BBaughman7/RotorTemperatureProject/FinalDesign/ElectricalDesign/Schematic PDFs/senior_prj_board_layout.pdf

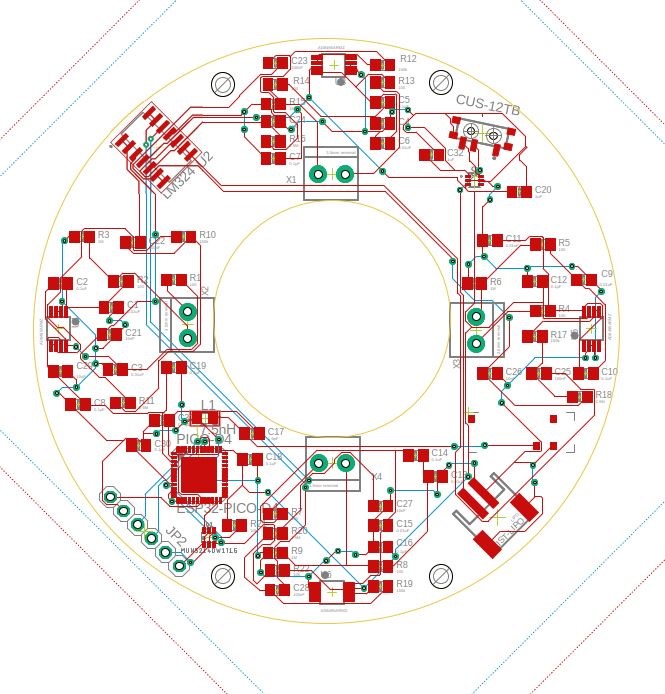
[picture p1: figure]
