BBaughman7/RotorTemperatureProject/Proof of Concept/Proof_of_Concept_BOM.xlsx

# | Description | Manufacturer/Seller | Quanity | Link | Price
1 | Breadboard | REXQualis | 1 | Link (https://www.amazon.com/Breadboards-Solderless-Breadboard-Distribution-Connecting/dp/B07DL13RZH) | $8.99
2 | TinyPico Development Board | Adafruit Industries LLC | 1 | Link (https://www.adafruit.com/product/5028) | $21.95
3 | LiPo Battery Charger | Adafruit Industries LLC | 1 | Link (https://www.adafruit.com/product/1904) | $6.95
4 | ESP-WROOM-32 Development Board | HiLetgo | 1 | Link (https://www.digipart.com/part/ESP32-WROOM-32D?msclkid=14f2ea9f09a613ca92648cae10fc4b53) | $4.10
5 | 1200 mAh LiPo Battery | Adafruit Industries LLC | 1 | Link (https://www.adafruit.com/product/258) | $9.95
6 | AD8495 Breakout Board | Adafruit Industries LLC | 1 | Link (https://www.adafruit.com/product/1778) | $11.95
7 | K-Type Thermocouple | Adafruit Industries LLC | 1 | Link (https://www.adafruit.com/product/270) | $9.95
8 | Ceramic Chip Capacitors | Kemet | 1 | Link (https://www.digikey.com/en/products/detail/kemet/CER-ENG-KIT-29/5039067) | $48.74
9 | 1/4W Axial Resistor Kit | Yageo | 1 | Link (https://www.digikey.com/en/products/detail/yageo/RS150/7109) | $41.79
10 | LM324 | TI | 1 | Link (https://www.digikey.com/en/products/detail/texas-instruments/LM324N-NOPB/4733936) | $1.17
 |  |  |  | Total | $165.54
