BBaughman7/RotorTemperatureProject/FinalDesign/Hardware/Final_Design_BOM.xlsx

Comment | Designator | Footprint | JLCPCB Part #（optional） | MFR Part# | Link to Part
0.01uF | C1,C3,C4,C6,C9,C11,C13,C15,C21,C24,C26,C27 | 0805 | C2971995 | 0805CG103J500NT | Link (https://jlcpcb.com/partdetail/3365237-0805CG103J500NT/C2971995)
0.1uF | C2,C5,C7,C8,C10,C12,C14,C16,C18,C19,C22,C23,C25,C28,C30 | 0805 | C2169476 | GCD21BR72A104KA01L | Link (https://jlcpcb.com/partdetail/2261541-GCD21BR72A104KA01L/C2169476)
0.75pF | C31 | 0805 | C519950 | CC0805CRNPO9BNR75 | Link (https://jlcpcb.com/partdetail/Yageo-CC0805CRNPO9BNR75/C519950)
1uF | C20,C32 | 0805 | C89378 | 0805F105M250NT | Link (https://jlcpcb.com/partdetail/90558-0805F105M250NT/C89378)
1.5pF | C17 | 0805 | C376869 | TCC0805COG1R5C500BT | Link (https://jlcpcb.com/partdetail/Cctc-TCC0805COG1R5C500BT/C376869)
10uF | C29 | 0805 | C17024 | CL21A106KPFNNNE | Link (https://jlcpcb.com/partdetail/17708-CL21A106KPFNNNE/C17024)
7.5nH | L1 | 0805 | C162658 | LQW2BAS7N5J00L | Link (https://jlcpcb.com/partdetail/MurataElectronics-LQW2BAS7N5J00L/C162658)
2.5M Ohm | R11,R16,R18,R20 | 0805 | C153398 | TR0805D2M5P0515 | Link (https://jlcpcb.com/partdetail/Ever_OhmsTech-TR0805D2M5P0515/C153398)
1M Ohm | R3,R6,R9,R15 | 0805 | C881016 | CR0805F1M00P05Z | Link (https://jlcpcb.com/partdetail/Ever_OhmsTech-CR0805F1M00P05Z/C881016)
150k Ohm | R10,R12,R17,R19 | 0805 | C276119 | RK73B2ATTD154J | Link (https://jlcpcb.com/partdetail/Koa_SpeerElec-RK73B2ATTD154J/C276119)
10k Ohm | R21,R22 | 0805 | C2912585 | HoAR0805-1/8W-10KR-0.1%-TCR25 | Link (https://jlcpcb.com/partdetail/C2912585)
100 Ohm | R1,R2,R4,R5,R7,R8,R13,R14 | 0805 | C346733 | RTAN0805BKE100R | Link (https://jlcpcb.com/partdetail/sei_stackpole_elec-RTAN0805BKE100R/C346733)
ESP32-PICO-D4 | PICO-D4 | QFN-48-EP(7x7) | C193707 | ESP32-PICO-D4 | Link (https://jlcpcb.com/partdetail/EspressifSystems-ESP32_PICOD4/C193707)
CUS-12TB | S | SMD | C2921739 | CUS-12TB | Link (https://jlcpcb.com/partdetail/Nidec-CUS12TB/C2921739)
LM324AMX/NOPB | U2 | SOIC-14 | C2057290 | LM324AMX/NOPB | Link (https://jlcpcb.com/partdetail/TexasInstruments-LM324AMXNOPB/C2057290)
NCP170AXV300T2G | U1 | SOT-563 | C463131 | NCP170AXV300T2G | Link (https://jlcpcb.com/partdetail/Onsemi-NCP170AXV300T2G/C463131)
PRO-OB-440 | U$35 | SMD | C5122736 | PRO-OB-440 | Link (https://jlcpcb.com/partdetail/AbraconLlc-PRO_OB440/C5122736)
MUN5214DW1T1G | Q1 | SOT-363 | C94403 | MUN5214DW1T1G | Link (https://jlcpcb.com/partdetail/Onsemi-MUN5214DW1T1G/C94403)
S2B-PH-SM4-TB(LF)(SN) | JST-LIPO | SMD,P=2mm | C295747 | S2B-PH-SM4-TB(LF)(SN) | Link (https://jlcpcb.com/partdetail/Jst-S2B_PH_SM4_TB_LF_SN/C295747)
AD8495ARMZ-R7 | U3,U4,U5,U6 | MSOP-8 | C59658 | AD8495ARMZ-R7 | Link (https://jlcpcb.com/partdetail/AnalogDevices-AD8495ARMZR7/C59658)
MF254V-11-06-1000-H70 | JP2 | Plugin,P=2.54mm | C2848407 | MF254V-11-06-1000-H70 | Link (https://jlcpcb.com/partdetail/Xfcn-MF254V_11_06_1000H70/C2848407)
DB301V-3.5-2P-GN-S | X1,X2,X3,X4 | Plugin,P=3.5mm | C695629 | DB301V-3.5-2P-GN-S | Link (https://jlcpcb.com/partdetail/Dorabo-DB301V_3_5_2P_GNS/C695629)
