BBaughman7/RotorTemperatureProject/FinalDesign/ElectricalDesign/Schematic PDFs/senior_prj_schematic.pdf

## fc = 8 Hz

U2G$1

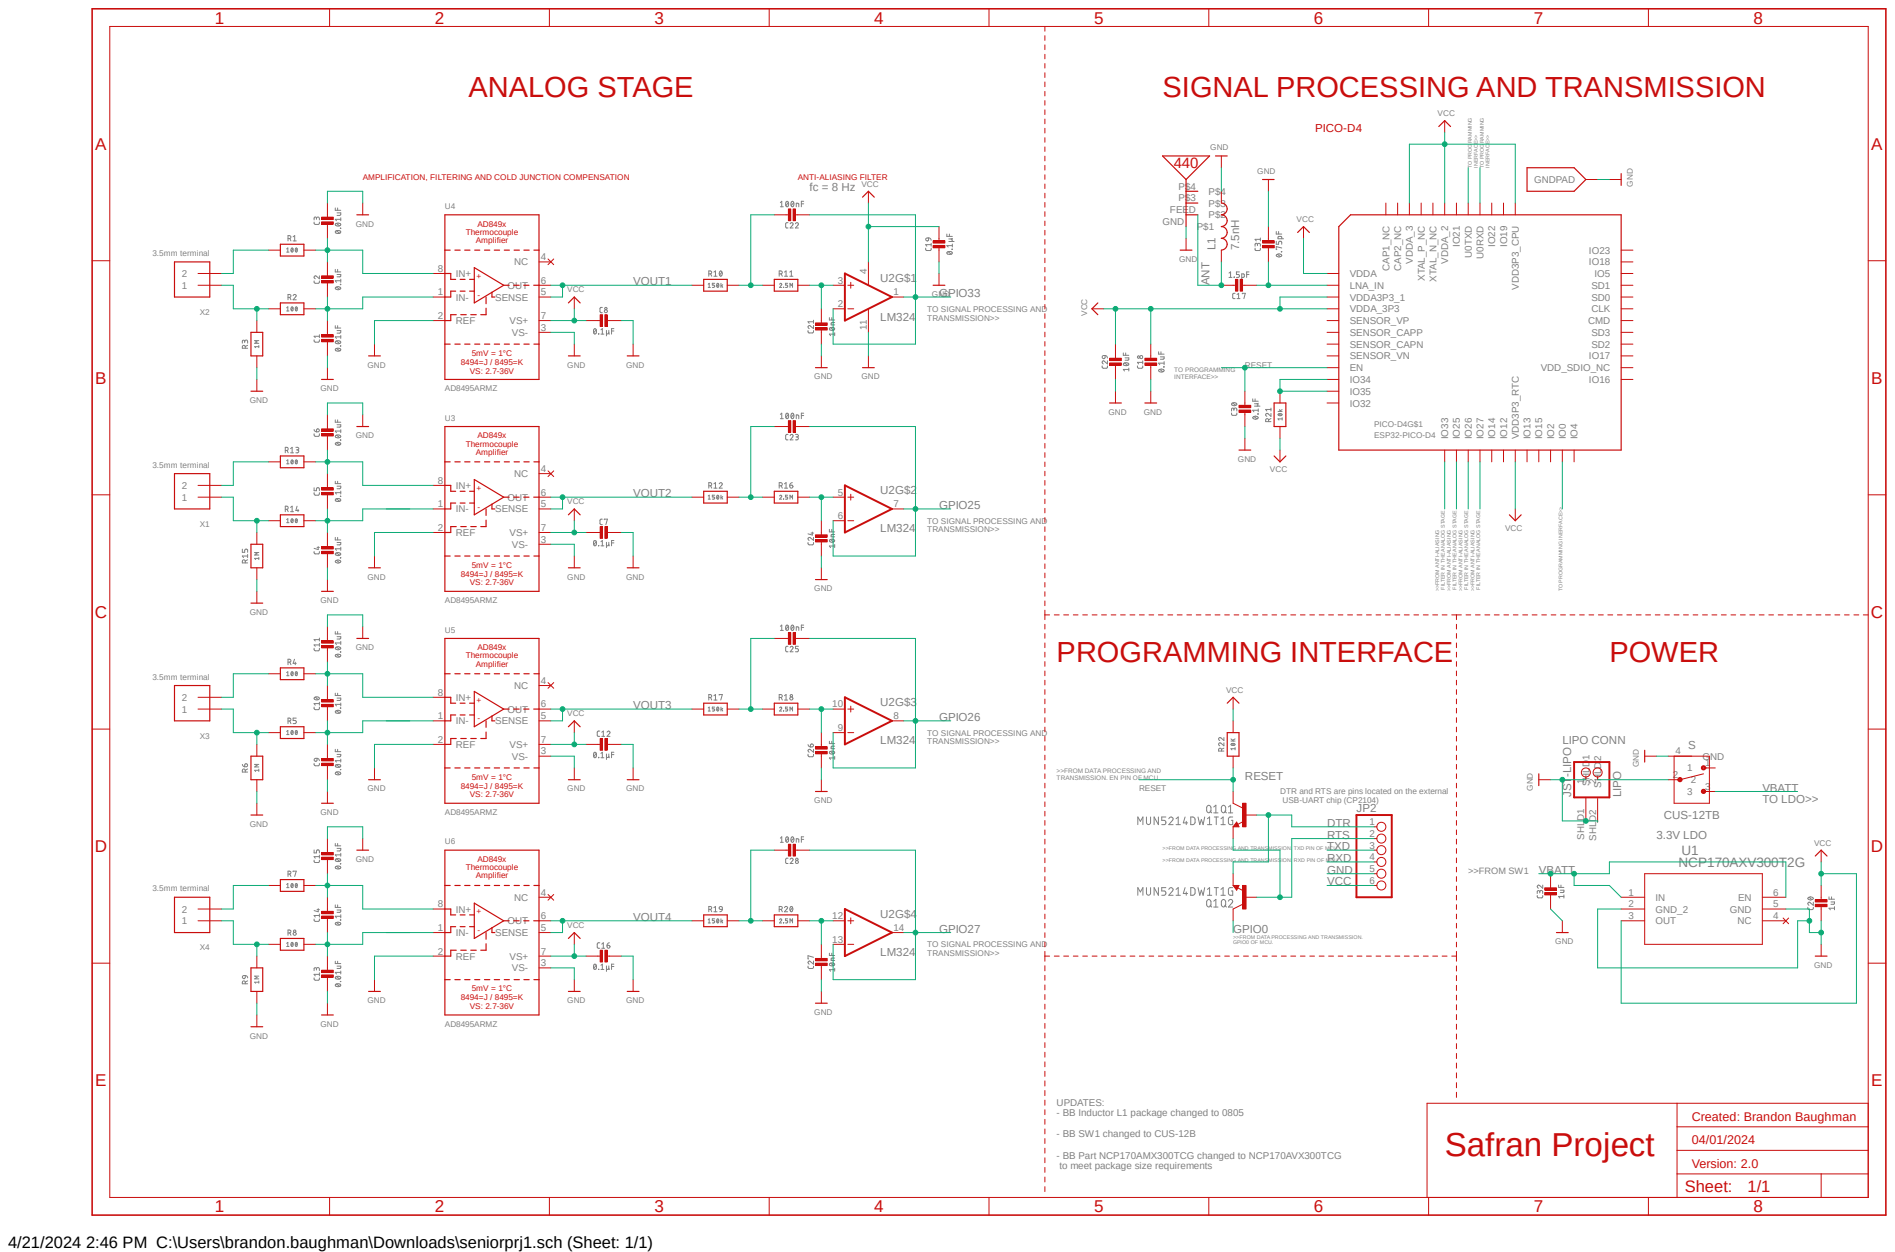
[picture p2: page 1]

SIGNAL PROCESSING AND TRANSMISSION
DTR ANT

IO23 VDD³P³_CPU IO²² IO¹⁹ U⁰TXD U⁰RXD IO²¹ VDDA_2 XTAL_P_NC XTAL_N_NC

>>FROM DATA PROCESSING AND
TRANSMISSION. EN PIN OF MCU.

DTR and RTS are pins located on the external
USB-UART chip (CP2104)

UPDATES: - BB Inductor L1 package changed to 0805

- BB SW1 changed to CUS-12B

- BB Part NCP170AMX300TCG changed to NCP170AVX300TCG
to meet package size requirements

4/21/2024 2:46 PM C:\Users\brandon.baughman\Downloads\seniorprj1.sch (Sheet: 1/1)
