BBaughman7/RotorTemperatureProject/FinalDesign/ElectricalDesign/Eagle/seniorprj1.brd

## EAGLE design FinalDesign/ElectricalDesign/Eagle/seniorprj1.brd (2024-04-30)

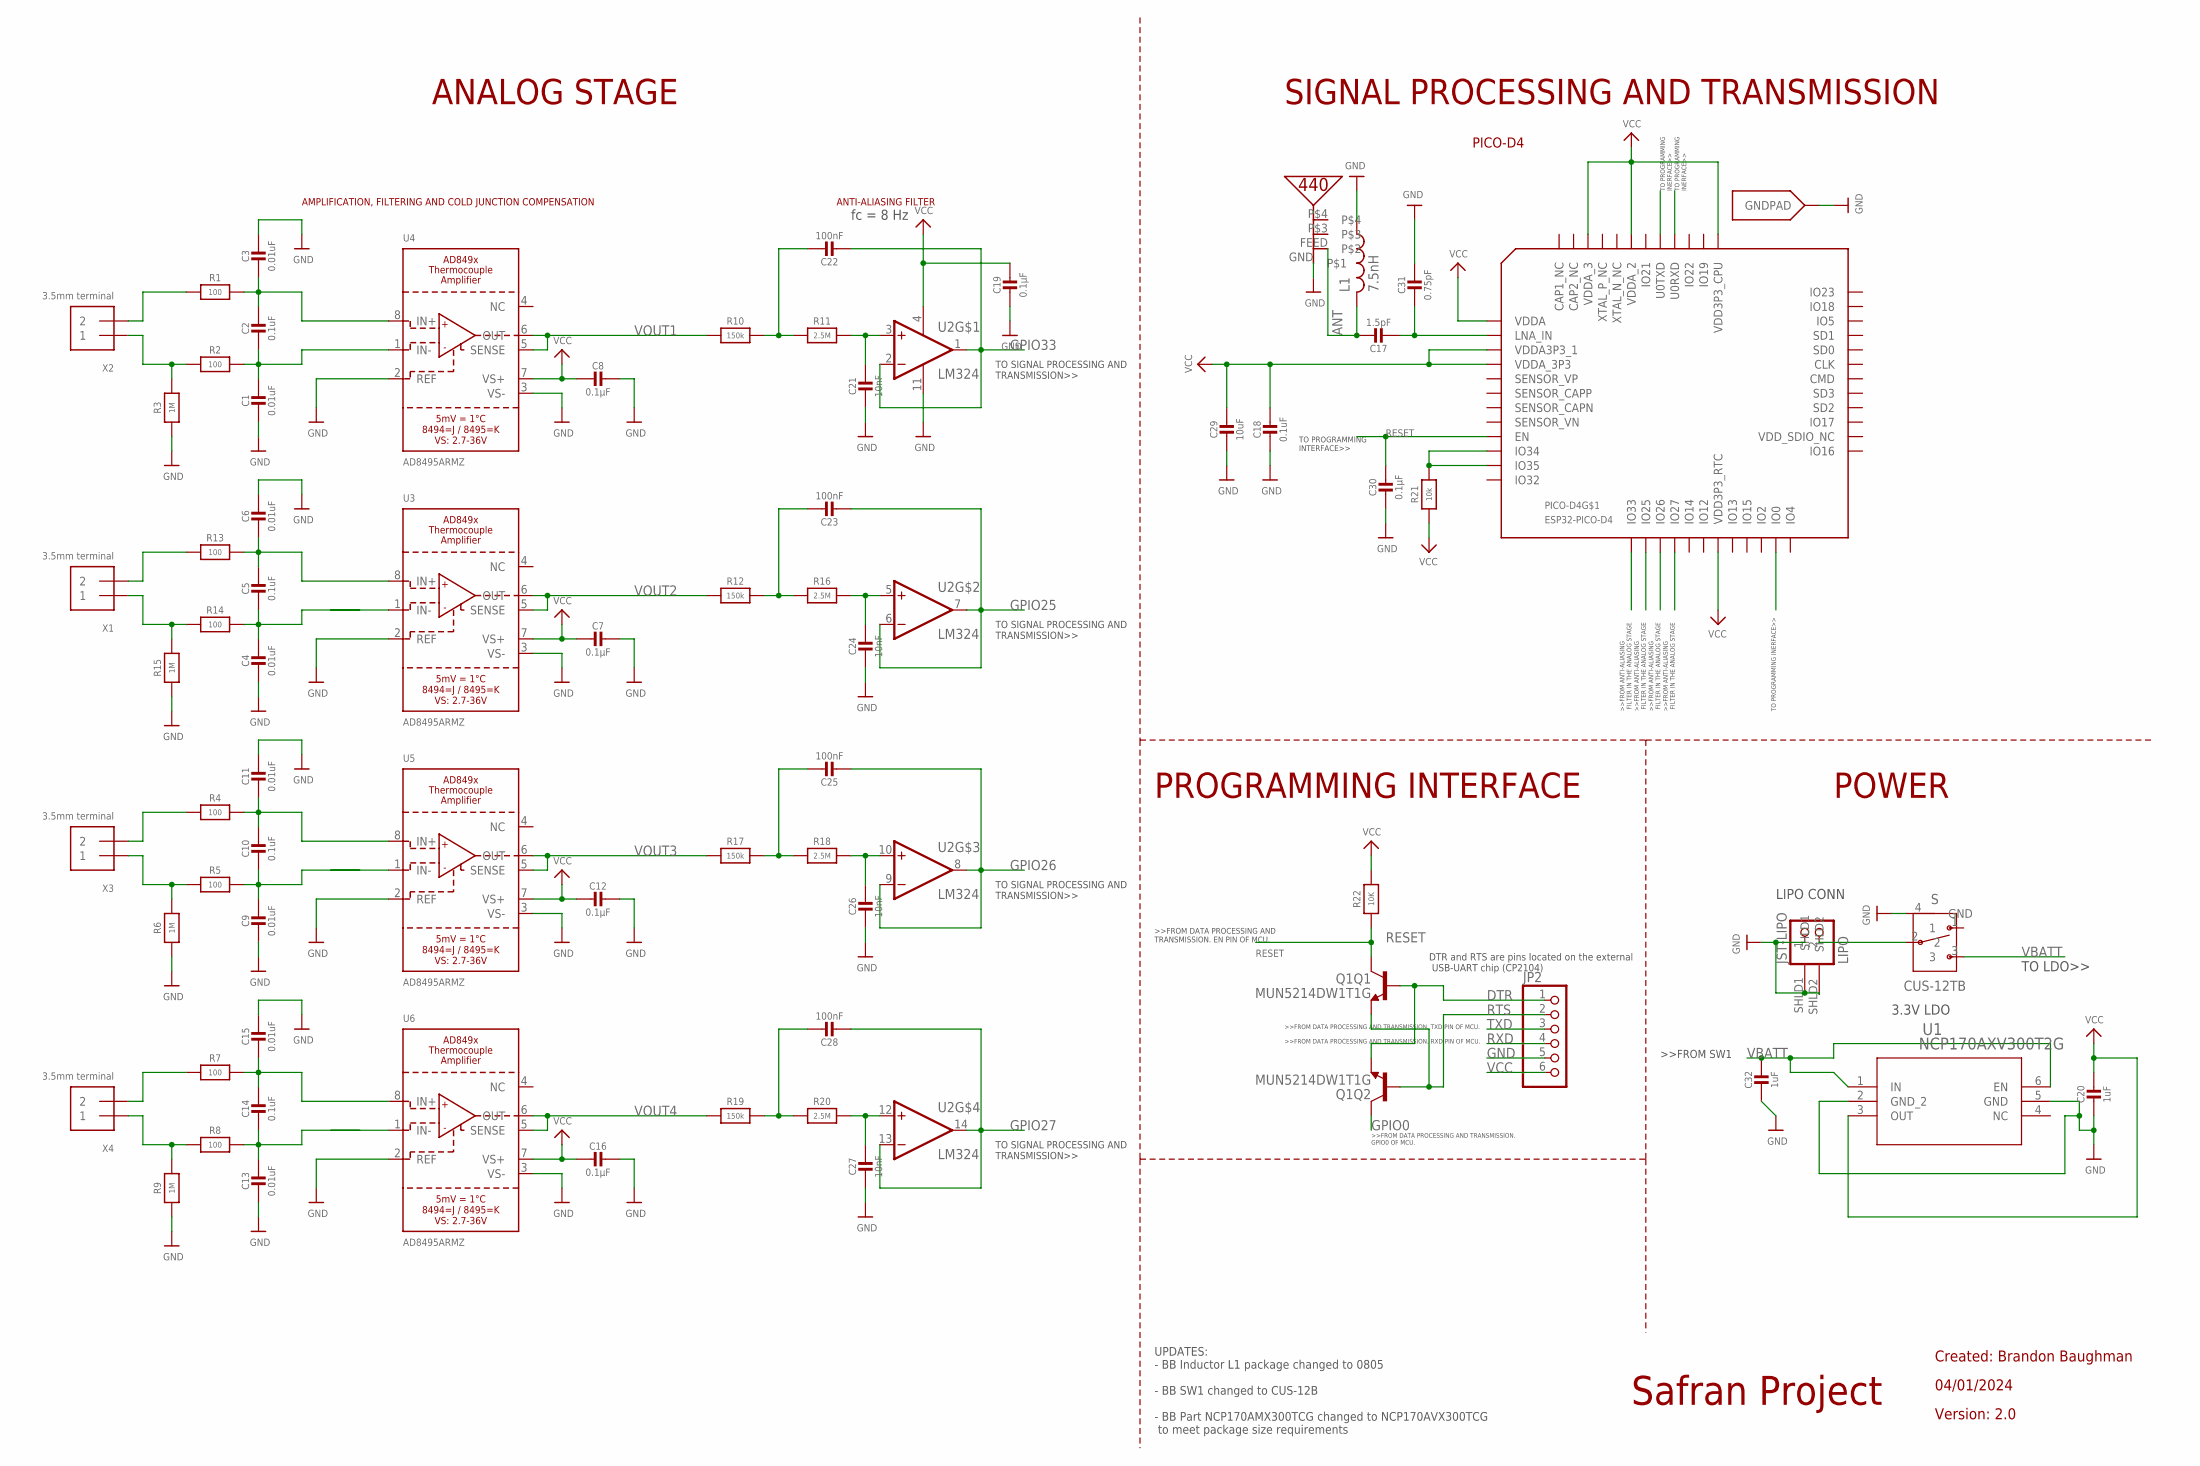
[picture p3: schematic seniorprj1.sch]

Parts:
C1, C3, C4, C6, C9, C11, C13, C15: 0.01uF; 0805-NO@1; MPN R76PD2100SE30J
C2, C5, C10, C14, C18: 0.1uF; 0805-NO@1; MPN C0805C104K1RECTU
C7, C8, C12, C16, C19, C30: 0.1µF; 0805-NO@1; MPN C0805C104K1RECTU
C17: 1.5pF; 0805-NO@1; MPN CC0805CRNPO9BN1R5
C20, C32: 1uF; 0805-NO@1; MPN 08051C105K4T2A
C21, C24, C26, C27: 10nF; 0805-NO@1; MPN C0805C103K1RECTU
C22, C23, C25, C28: 100nF; 0805-NO@1; MPN C0805C104K1RECTU
C29: 10uF; 0805-NO@1; MPN C0805C106J8RACAUTO
C31: 0.75pF; 0805-NO@1
JP2: PINHD-1X6; 1X06; MPN 826631-6
JST-LIPO: LIPO; JSTPH2
L1: 7.5nH; RESC0805_N; MPN BSPQ000603047N5H00
PICO-D4: ESP32-PICO-D4; PICO-D4-QFN48
Q1: MUN5214DW1T1G; DUAL_NPN_SC70-6; MPN MUN5214DW1T1G
R1, R2, R4, R5, R7, R8, R13, R14: 100; 0805-NO; MPN CRCW0805100RFKTA
R3, R6, R9, R15: 1M; 0805-NO; MPN ERJ-P06J105V
R10, R12, R17, R19: 150k; 0805-NO; MPN CRCW0805150KFKEA
R11, R16, R18, R20: 2.5M; 0805-NO
R21: 10k; 0805-NO; MPN RC0805FR-0710KL
R22: 10K; 0805-NO; MPN RC0805FR-0710KL
S: CUS-12TB; CUS-12B
U1: NCP170AXV300T2G; SOT-563_1P3X1P7_ONS
U2: LM324; SOIC127P600X175-14N; MPN LM324N/NOPB
U3, U4, U5, U6: AD8495ARMZ; MSOP8_0.65MM; MPN AD8495ARMZ-R7
U$35: PRO-OB-440
X1, X2, X3, X4: 3.5mm terminal; TERMBLOCK_1X2-3.5MM; MPN MA212-350M02

Connections:
ANT: C17.1, L1.2, U$35.FEED
DTR: JP2.1, Q1.1 (E), Q1.5 (B)
GND: C1.2, C3.1, C4.2, C6.1, C7.1, C8.1, C9.2, C11.1, C12.1, C13.2, C15.1, C16.1, C18.2, C19.2, C20.2, C21.2, C24.2, C26.2, C27.2, C29.2, C30.2, C31.1, C32.2, JP2.5, JST-LIPO.1, JST-LIPO.SHLD1, JST-LIPO.SHLD2, L1.1, PICO-D4.EXP (GNDPAD), R3.1, R6.1, R9.1, R15.1, S.4 (GND), U1.2 (GND_2), U1.5 (GND), U2.11 (VCC-), U3.2 (REF), U3.3 (VS-), U4.2 (REF), U4.3 (VS-), U5.2 (REF), U5.3 (VS-), U6.2 (REF), U6.3 (VS-), U$35.GND
GPIO0: PICO-D4.23 (IO0), Q1.6 (C)
GPIO25: C23.2, U2.6 (INVERTING_INPUT2), U2.7 (OUTPUT2)
GPIO26: C25.2, U2.8 (OUTPUT3), U2.9 (INVERTING_INPUT3)
GPIO27: C28.2, U2.13 (INVERTING_INPUT4), U2.14 (OUTPUT4)
GPIO33: C22.2, U2.1 (OUTPUT1), U2.2 (INVERTING_INPUT1)
IN+: R13.1, X1.2
IN+1: R1.1, X2.2
IN+2: R4.1, X3.2
IN+3: R7.1, X4.2
IN-: R14.1, R15.2, X1.1
IN-1: R2.1, R3.2, X2.1
IN-2: R5.1, R6.2, X3.1
IN-3: R8.1, R9.2, X4.1
IO12: PICO-D4.18 (IO12)
IO21: PICO-D4.42 (IO21)
LNA_IN: C17.2, C31.2, PICO-D4.2 (LNA_IN)
unnamed: C2.1, C3.2, R1.2, U4.8 (IN+)
unnamed: C5.1, C6.2, R13.2, U3.8 (IN+)
unnamed: C4.1, C5.2, R14.2
unnamed: C1.1, C2.2, R2.2, U4.1 (IN-)
unnamed: C10.1, C11.2, R4.2, U5.8 (IN+)
unnamed: C9.1, C10.2, R5.2
unnamed: C14.1, C15.2, R7.2, U6.8 (IN+)
unnamed: C13.1, C14.2, R8.2
unnamed: JST-LIPO.2, S.2
unnamed: C22.1, R10.2, R11.1
unnamed: C21.1, R11.2, U2.3 (NON-INVERTING_INPUT1)
unnamed: C24.1, R16.2, U2.5 (NON-INVERTING_INPUT2)
unnamed: C23.1, R12.2, R16.1
unnamed: C25.1, R17.2, R18.1
unnamed: C28.1, R19.2, R20.1
unnamed: C26.1, R18.2, U2.10 (NON-INVERTING_INPUT3)
unnamed: C27.1, R20.2, U2.12 (NON-INVERTING_INPUT4)
unnamed: PICO-D4.10 (IO34), PICO-D4.11 (IO35), R21.2
RESET: C30.1, PICO-D4.9 (EN), Q1.3 (C), R22.1
RTS: JP2.2, Q1.2 (B), Q1.4 (E)
RXD: JP2.4, PICO-D4.40 (U0RXD)
SENSOR_CAPN: PICO-D4.7 (SENSOR_CAPN)
TXD: JP2.3, PICO-D4.41 (U0TXD)
VBATT: C32.1, S.3, U1.1 (IN), U1.6 (EN)
VCC: C7.2, C8.2, C12.2, C16.2, C18.1, C19.1, C20.1, C29.1, JP2.6, PICO-D4.1 (VDDA), PICO-D4.3 (VDDA3P3_1), PICO-D4.4 (VDDA_3P3), PICO-D4.19 (VDD3P3_RTC), PICO-D4.37 (VDD3P3_CPU), PICO-D4.43 (VDDA_2), PICO-D4.46 (VDDA_3), R21.1, R22.2, U1.3 (OUT), U2.4 (VCC+), U3.7 (VS+), U4.7 (VS+), U5.7 (VS+), U6.7 (VS+)
VOUT1: R10.1, U4.5 (SENSE), U4.6 (OUT)
VOUT2: R12.1, U3.5 (SENSE), U3.6 (OUT)
VOUT3: R17.1, U5.5 (SENSE), U5.6 (OUT)
VOUT4: R19.1, U6.5 (SENSE), U6.6 (OUT)

Notes on the sheet:
LIPO CONN
Created: Brandon Baughman
Safran Project
04/01/2024
Version: 2.0
PICO-D4
ANALOG STAGE
PROGRAMMING INTERFACE
POWER
SIGNAL PROCESSING AND TRANSMISSION
UPDATES: - BB Inductor L1 package changed to 0805 - BB SW1 changed to CUS-12B - BB Part NCP170AMX300TCG changed to NCP170AVX300TCG to meet package size requirements
DTR and RTS are pins located on the external USB-UART chip (CP2104)
AMPLIFICATION, FILTERING AND COLD JUNCTION COMPENSATION
ANTI-ALIASING FILTER
TO SIGNAL PROCESSING AND TRANSMISSION>>
TO PROGRAMMING INERFACE>>
TO PROGRAMMING INTERFACE>>
TO PROGRAMMING INERFACE>>
TO LDO>>
3.3V LDO
fc = 8 Hz

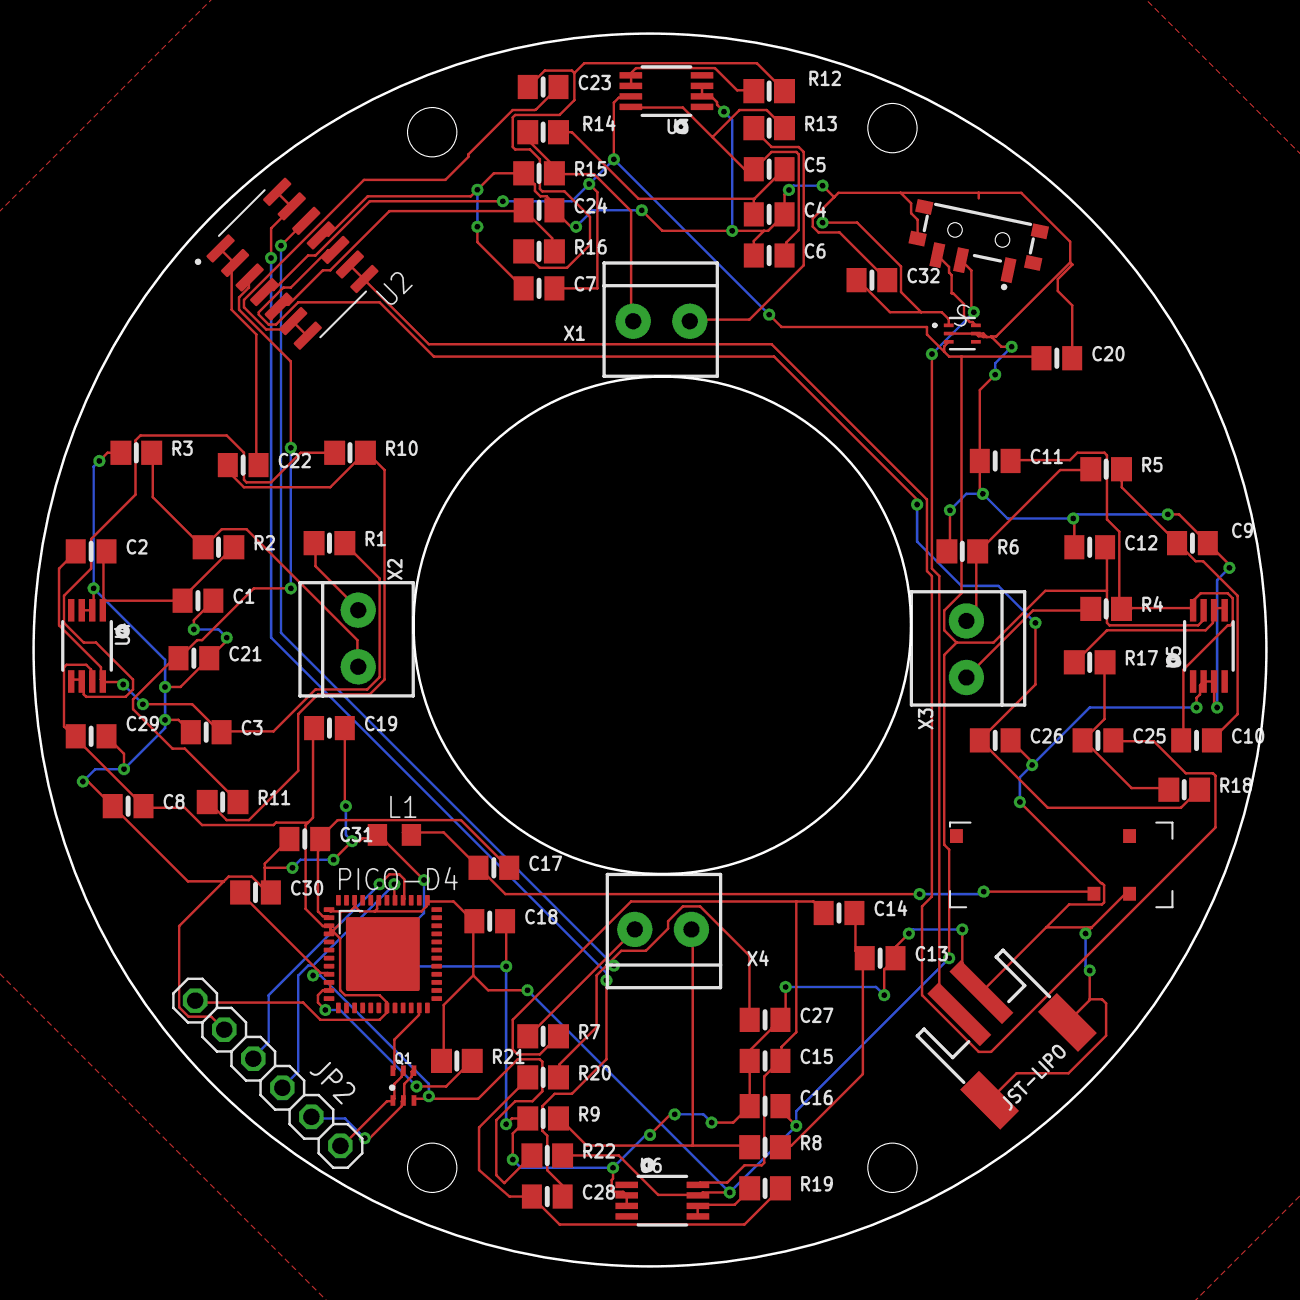
[picture p4: board seniorprj1.brd from above]

Board: 2 copper layers, 76.2 x 76.2 mm, 71 parts (0 on the bottom side), 45 nets.
