BBaughman7/RotorTemperatureProject/FinalDesign/Software/BLE_Client/ESP32_BLE_TEMP_CLIENT.ino

#include "BLEDevice.h"


static BLEUUID serviceUUID((uint16_t)0x181A);//service UUID from the server
static BLEUUID charUUID((uint16_t)0x2A6E);//characteritic UUID from server

static boolean doConnect = false;
static boolean connected = false;
static boolean doScan = false;
static BLERemoteCharacteristic* pRemoteCharacteristic;
static BLEAdvertisedDevice* myDevice;



static void notifyCallback(BLERemoteCharacteristic* pBLERemoteCharacteristic,uint8_t* pData,size_t length, bool isNotify) 
{    
    Serial.println((char*)pData);
}

class MyClientCallback : public BLEClientCallbacks 
{
  void onConnect(BLEClient* pclient) 
  {
  }

  void onDisconnect(BLEClient* pclient) 
  {
    connected = false;
    Serial.println("onDisconnect");
  }
};

bool connectToServer() 
{
    BLEClient*  pClient  = BLEDevice::createClient();
    pClient->setClientCallbacks(new MyClientCallback());

    // Connect to the BLE Server.
    pClient->connect(myDevice);  // if you pass BLEAdvertisedDevice instead of address, it will be recognized type of peer device address (public or private)

    // Obtain a reference to the service we are after in the remote BLE server.
    BLERemoteService* pRemoteService = pClient->getService(serviceUUID);
    if (pRemoteService == nullptr)
    {   
      pClient->disconnect();
      return false;
    }

    // Obtain a reference to the characteristic in the service of the remote BLE server.
    pRemoteCharacteristic = pRemoteService->getCharacteristic(charUUID);
    if (pRemoteCharacteristic == nullptr) 
    {
      pClient->disconnect();
      return false;
    }

    // Read the value of the characteristic.
    if(pRemoteCharacteristic->canRead()) 
    {
      std::string value = pRemoteCharacteristic->readValue();
    }

    if(pRemoteCharacteristic->canNotify())
      pRemoteCharacteristic->registerForNotify(notifyCallback);

    connected = true;
    return true;
}
/**
 * Scan for BLE servers and find the first one that advertises the service we are looking for.
 */
class MyAdvertisedDeviceCallbacks: public BLEAdvertisedDeviceCallbacks 
{
   // Called for each advertising BLE server.
  void onResult(BLEAdvertisedDevice advertisedDevice) 
  {
    // We have found a device, let us now see if it contains the service we are looking for.
    if (advertisedDevice.haveServiceUUID() && advertisedDevice.isAdvertisingService(serviceUUID)) 
    {
      BLEDevice::getScan()->stop();//we have found the correct server. stop scanning.
      myDevice = new BLEAdvertisedDevice(advertisedDevice);
      doConnect = true;
      doScan = true;
    }
  } 
}; 

void setup() 
{
  Serial.begin(115200, SERIAL_8N1);
  BLEDevice::init("");
  // Retrieve a Scanner and set the callback we want to use to be informed when we
  // have detected a new device.  Specify that we want active scanning and start the
  // scan to run for 5 seconds. CHECK BLEScan.h FOR INFO ON FUNCTION CALLS HERE
  BLEScan* pBLEScan = BLEDevice::getScan();
  pBLEScan->setAdvertisedDeviceCallbacks(new MyAdvertisedDeviceCallbacks());
  pBLEScan->setInterval(1349);//how long to wait between scans
  pBLEScan->setWindow(449);//how long to scan
  pBLEScan->setActiveScan(true);
  pBLEScan->start(5, false);
} // End of setup.

void loop()
{

  // If the flag "doConnect" is true then we have scanned for and found the desired
  // BLE Server with which we wish to connect.  Now we connect to it.  Once we are 
  // connected we set the connected flag to be true.
  if (doConnect == true) 
  {
    if (connectToServer()) 
    {
      //Serial.println("We are now connected to the BLE Server.");
    } 
    else 
    {
      //Serial.println("We have failed to connect to the server; there is nothin more we will do.");
    }
    doConnect = false;
  }
  delay(1000); // Delay a second between loops.
} // End of loop
